Open-Research-Technologies-Hub/FARESHARE/hardware/3D print files/RFID Housing Left.STL

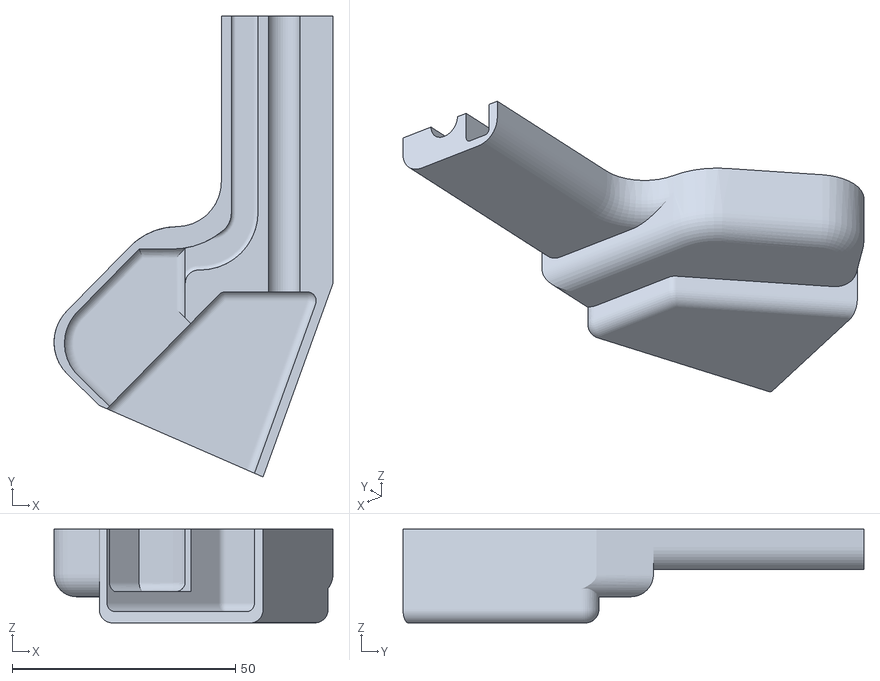
[picture p1: CAD file, 2024-04-05]
hardware/3D print files/RFID Housing Left.STL
62.4 x 103.2 x 21.0
