Open-Research-Technologies-Hub/FARESHARE/hardware/3D print files/Box.STL

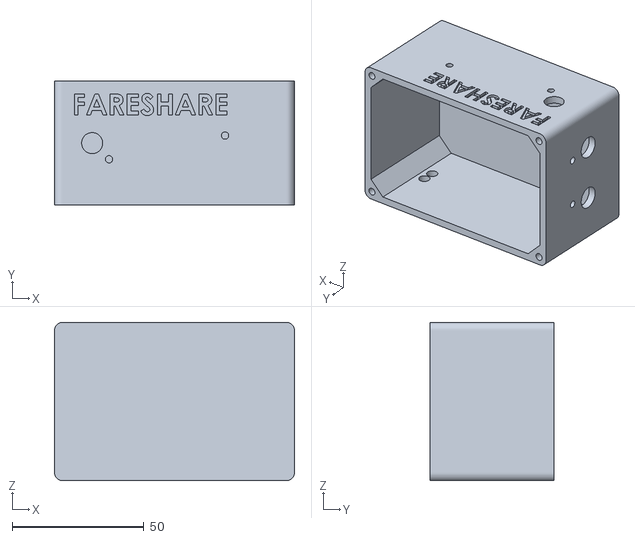
[picture p2: CAD file, 2024-04-05]
hardware/3D print files/Box.STL
91.0 x 47.0 x 60.0
