Open-Research-Technologies-Hub/FARESHARE/hardware/3D print files/Pump Case.STL

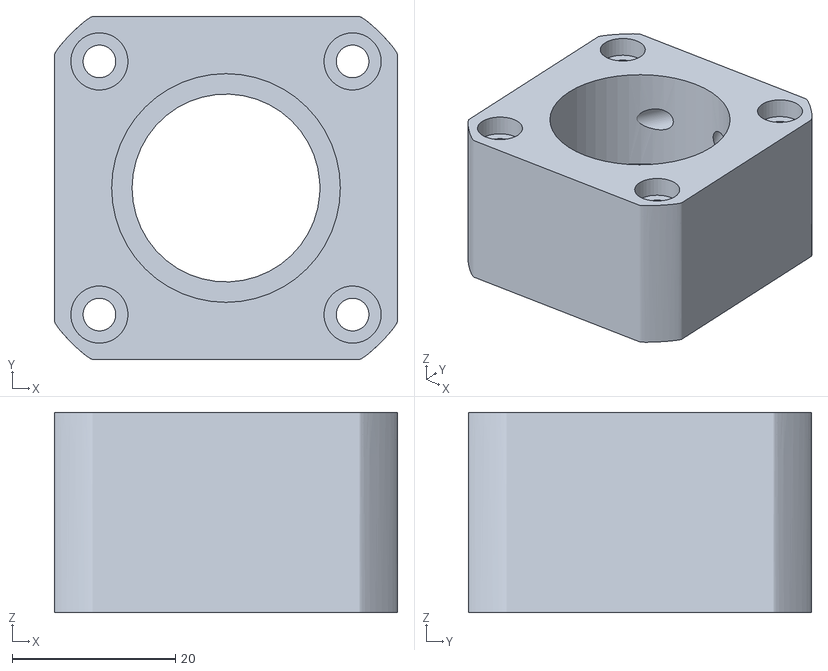
[picture p3: CAD file, 2024-04-05]
hardware/3D print files/Pump Case.STL
42.0 x 42.0 x 24.5
