Open-Research-Technologies-Hub/FARESHARE/hardware/3D print files/Box_lid.STL

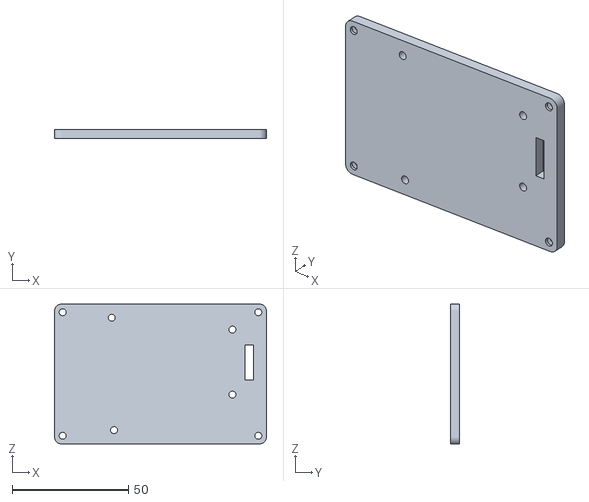
[picture p4: CAD file, 2024-04-05]
hardware/3D print files/Box_lid.STL
91.0 x 4.00 x 60.0
