Open-Research-Technologies-Hub/FARESHARE/hardware/3D print files/Rotor.STL

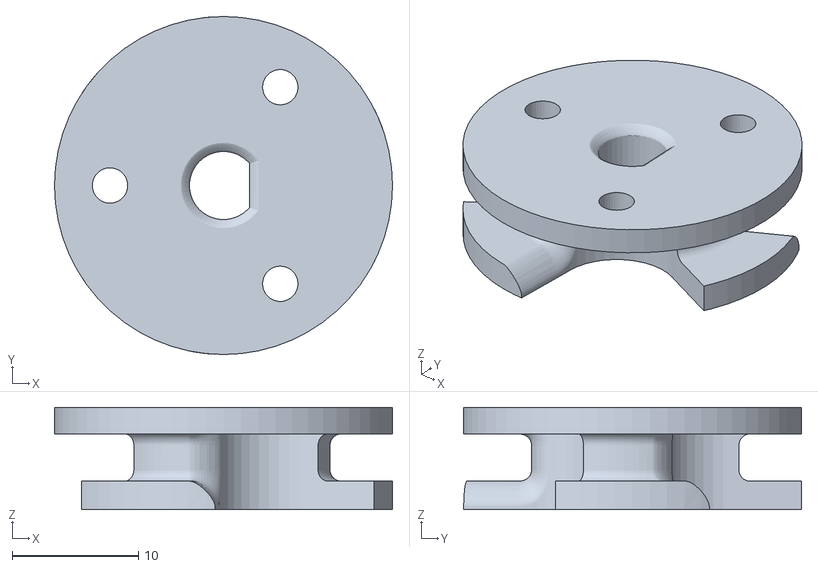
[picture p5: CAD file, 2024-04-05]
hardware/3D print files/Rotor.STL
26.8 x 26.8 x 8.10
