Open-Research-Technologies-Hub/FARESHARE/(list of files, cad)

Other CAD files:
hardware/3D print files/RFID Housing Right.STL
