Open-Research-Technologies-Hub/FARESHARE/(list of files, drawings)

Other design files:
FARESHARE PCB.fzz
