Open-Research-Technologies-Hub/FARESHARE/hardware/carvera_PCB/FARESHARE KICAD/FARESHARE KICAD.kicad_pcb

## KiCad design hardware/carvera_PCB/FARESHARE KICAD/FARESHARE KICAD.kicad_pcb (2024-05-10)

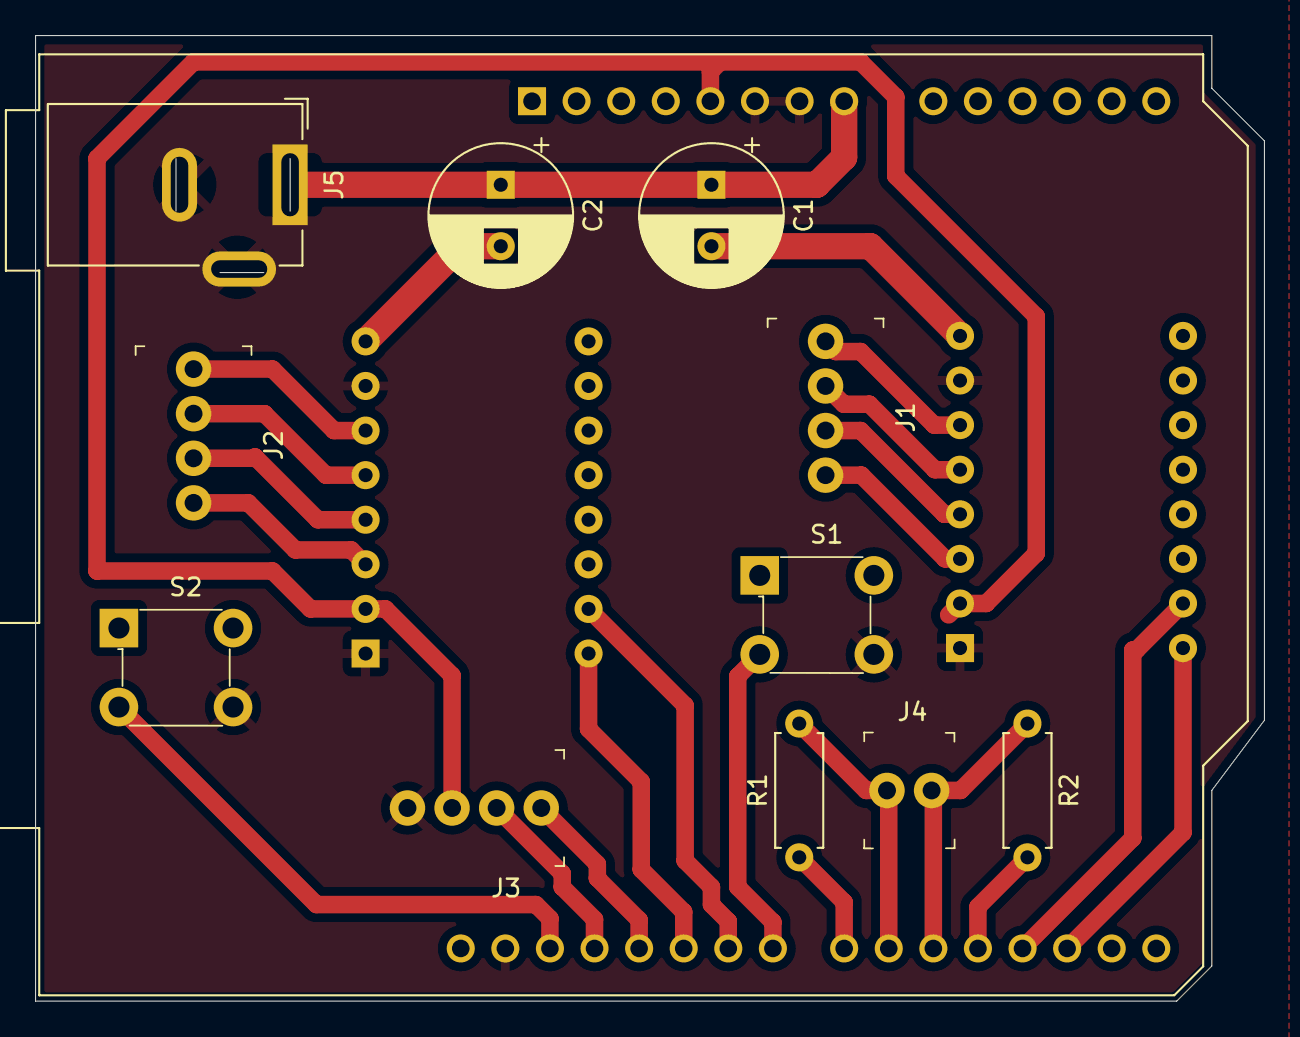
[picture p6: board FARESHARE KICAD.kicad_pcb from above]

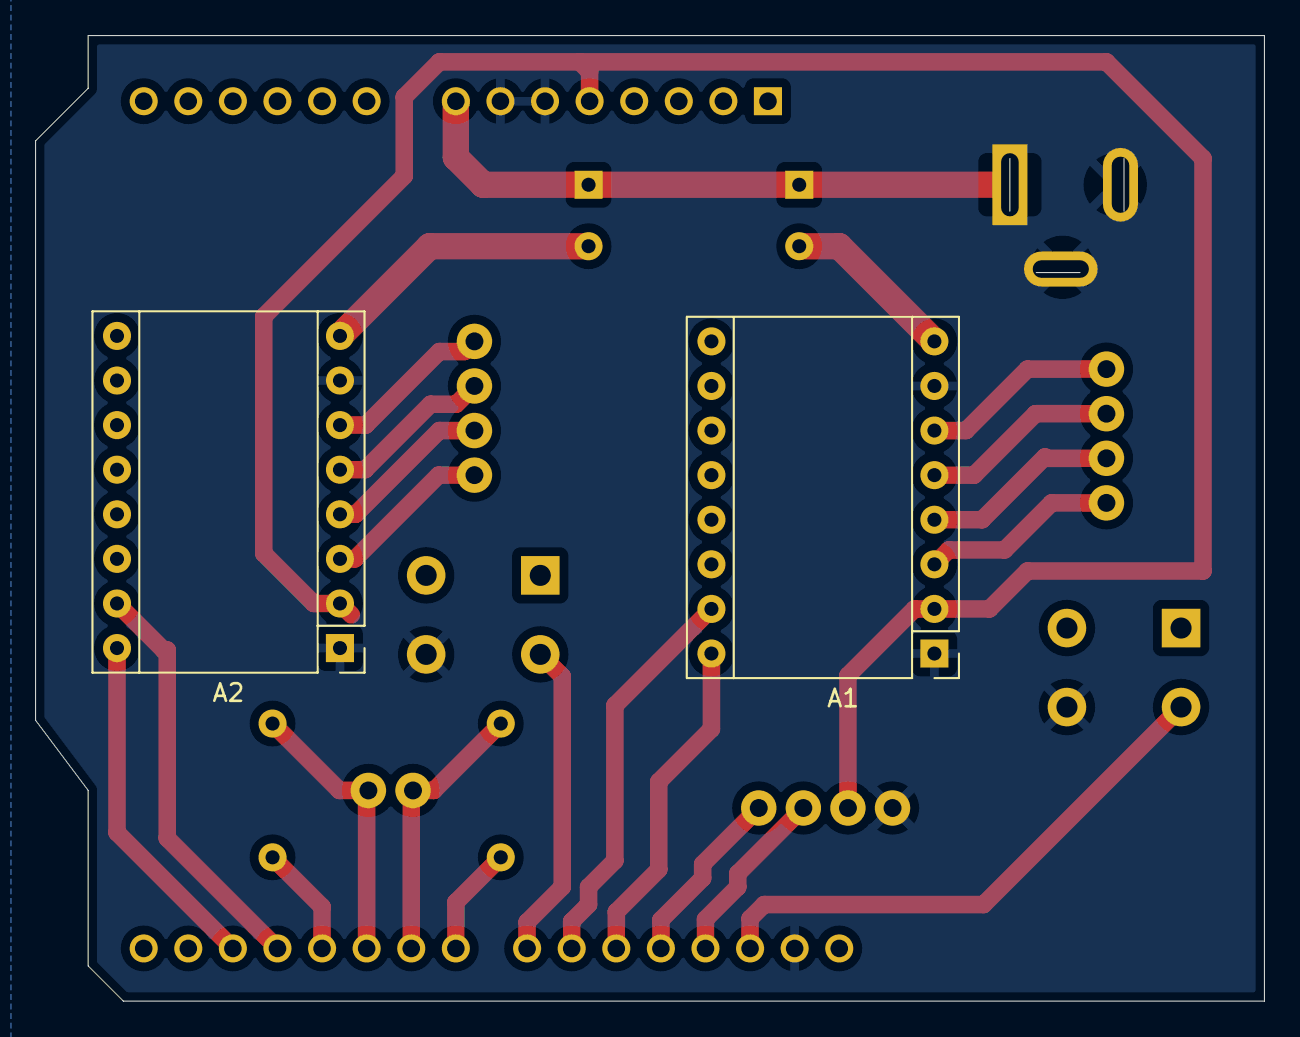
[picture p7: board FARESHARE KICAD.kicad_pcb from below]

Board: 2 copper layers, 70.0 x 55.0 mm, 14 parts (2 on the bottom side), 27 nets.

Parts:
A1, A2: Pololu_Breakout_A4988; Pololu_Breakout-16_15.2x20.3mm
A3: Arduino_UNO_R2
C1, C2: C_Polarized; CP_Radial_D8.0mm_P3.50mm
J1, J2, J3: 0022232041; PinHeader_1x4_P2.54mm_Drill1.02mm
J4: 22-23-2021; PinHeader_1x2_P2.54mm_Drill1.02mm
J5: Barrel_Jack_Switch_Pin3Ring; BarrelJack_GCT_DCJ200-10-A_Horizontal
R1, R2: R; R_Axial_DIN0207_L6.3mm_D2.5mm_P7.62mm_Horizontal
S1, S2: 1825910-6; Switch_Tactile_THT_6x6mm

Connections:
+5V: A1.2 (VDD), A2.2 (VDD), A3.5 (+5V), J3.3
+12V: A3.8 (VIN), C1.1, C2.1, J5.1
D2: A2.16 (DIR), A3.17 (D2)
D3: A2.15 (STEP), A3.18 (D3)
D4: A3.19 (D4), R2.2
D5: A3.20 (D5), J4.2, R2.1
D6: A3.21 (D6), J4.1, R1.2
D7: A3.22 (D7), R1.1
D8: A3.23 (D8), S1.3
D9: A1.15 (STEP), A3.24 (D9)
D10: A1.16 (DIR), A3.25 (D10)
D11: A3.26 (D11), J3.1
D12: A3.27 (D12), J3.2
D13: A3.28 (D13), S2.3
GND: A1.1 (GND), A1.7 (GND), A2.1 (GND), A2.7 (GND), A3.6 (GND), A3.7 (GND), A3.29 (GND), J3.4, J5.2, J5.3, S1.4, S2.4
unnamed: A1.4 (1A), J2.3
unnamed: A1.3 (1B), J2.4
unnamed: A1.5 (2A), J2.2
unnamed: A1.6 (2B), J2.1
unnamed: A1.8 (VMOT), C2.2
unnamed: A1.13 (~RESET), A1.14 (~SLEEP)
unnamed: A2.4 (1A), J1.3
unnamed: A2.3 (1B), J1.4
unnamed: A2.5 (2A), J1.2
unnamed: A2.6 (2B), J1.1
unnamed: A2.8 (VMOT), C1.2
unnamed: A2.13 (~RESET), A2.14 (~SLEEP)
