Open-Research-Technologies-Hub/FARESHARE/(commit log)

2024-04-05 move things around and create an editable BOM
    [Box.STL, Box_lid.STL, Pump Case.STL, RFID Housing Left.STL, RFID Housing Right.STL, Rotor.STL, fare_share_BOM.csv]
2024-04-19 move things around and create a board for carvera
    [FARESHARE PCB 2.0_contour.gm1, FARESHARE PCB 2.0_copperBottom.gbl, FARESHARE PCB 2.0_copperTop.gtl, FARESHARE PCB 2.0_maskBottom.gbs, FARESHARE PCB 2.0_maskTop.gts, FARESHARE PCB 2.0_silkBottom.gbo, FARESHARE PCB 2.0_silkTop.gto]
2024-05-05 added kicad pcb file
    [FARESHARE KICAD.kicad_pcb, FARESHARE KICAD.kicad_sch]
2024-05-06 circuit components added
2024-05-07 Kicad files updated
2024-05-07 PCb design and gerber files generated
    [FARESHARE KICAD-B_Cu.gbr, FARESHARE KICAD-B_Mask.gbr, FARESHARE KICAD-B_Paste.gbr, FARESHARE KICAD-B_Silkscreen.gbr, FARESHARE KICAD-Edge_Cuts.gbr, FARESHARE KICAD-F_Cu.gbr, FARESHARE KICAD-F_Mask.gbr, FARESHARE KICAD-F_Paste.gbr]
2024-05-07 Error corrected on Pcb and gerber file
2024-05-07 Pcb and gerber updated
    [FARESHARE KICAD-B_Cu.gbr, FARESHARE KICAD-B_Mask.gbr, FARESHARE KICAD-B_Paste.gbr, FARESHARE KICAD-B_Silkscreen.gbr, FARESHARE KICAD-Edge_Cuts.gbr, FARESHARE KICAD-F_Cu.gbr, FARESHARE KICAD-F_Mask.gbr, FARESHARE KICAD-F_Paste.gbr]
2024-05-08 added silk screen
    [FARESHARE KICAD.kicad_pcb, FARESHARE KICAD.kicad_sch]
2024-05-08 added the schematic file
    [FARESHARE KICAD.kicad_sch]
2024-05-08 gerbber files updated with a single sided pcb
    [FARESHARE KICAD-B_Cu.gbr, FARESHARE KICAD-B_Mask.gbr, FARESHARE KICAD-B_Paste.gbr, FARESHARE KICAD-B_Silkscreen.gbr, FARESHARE KICAD-Edge_Cuts.gbr, FARESHARE KICAD-F_Cu.gbr, FARESHARE KICAD-F_Mask.gbr, FARESHARE KICAD-F_Paste.gbr]
2024-05-08 updated pcb+ gerber
    [FARESHARE KICAD-B_Cu.gbr, FARESHARE KICAD-B_Mask.gbr, FARESHARE KICAD-B_Paste.gbr, FARESHARE KICAD-B_Silkscreen.gbr, FARESHARE KICAD-Edge_Cuts.gbr, FARESHARE KICAD-F_Cu.gbr, FARESHARE KICAD-F_Mask.gbr, FARESHARE KICAD-F_Paste.gbr]
2024-05-08 Cap size update
    [FARESHARE KICAD-B_Cu.gbr, FARESHARE KICAD-Edge_Cuts.gbr, FARESHARE KICAD-F_Cu.gbr, FARESHARE KICAD-F_Mask.gbr, FARESHARE KICAD-F_Paste.gbr, FARESHARE KICAD-NPTH.drl, FARESHARE KICAD-PTH.drl, FARESHARE KICAD-job.gbrjob]
2024-05-09 changed power footprint
    [FARESHARE KICAD-B_Cu.gbr, FARESHARE KICAD-Edge_Cuts.gbr, FARESHARE KICAD-F_Cu.gbr, FARESHARE KICAD-F_Mask.gbr, FARESHARE KICAD-F_Paste.gbr, FARESHARE KICAD-NPTH.drl, FARESHARE KICAD-PTH.drl, FARESHARE KICAD-job.gbrjob]
2024-05-10 changes on the barrel jack
    [FARESHARE KICAD-B_Cu.gbr, FARESHARE KICAD-Edge_Cuts.gbr, FARESHARE KICAD-F_Cu.gbr, FARESHARE KICAD-F_Mask.gbr, FARESHARE KICAD-F_Paste.gbr, FARESHARE KICAD-NPTH.drl, FARESHARE KICAD-PTH.drl, FARESHARE KICAD-job.gbrjob]
2024-05-10 barrel jack updated to a round one
    [FARESHARE KICAD-B_Cu.gbr, FARESHARE KICAD-Edge_Cuts.gbr, FARESHARE KICAD-F_Cu.gbr, FARESHARE KICAD-F_Mask.gbr, FARESHARE KICAD-F_Paste.gbr, FARESHARE KICAD-NPTH.drl, FARESHARE KICAD-PTH.drl, FARESHARE KICAD-job.gbrjob]
2024-05-10 Traces changed and other files updated accordingly
    [FARESHARE KICAD-B_Cu.gbr, FARESHARE KICAD-B_Mask.gbr, FARESHARE KICAD-B_Paste.gbr, FARESHARE KICAD-B_Silkscreen.gbr, FARESHARE KICAD-Edge_Cuts.gbr, FARESHARE KICAD-F_Cu.gbr, FARESHARE KICAD-F_Mask.gbr, FARESHARE KICAD-F_Paste.gbr]
2024-05-10 trying to use edge cut to cut slots
    [FARESHARE KICAD-B_Cu.gbr, FARESHARE KICAD-Edge_Cuts.gbr, FARESHARE KICAD-F_Cu.gbr, FARESHARE KICAD-F_Mask.gbr, FARESHARE KICAD-F_Paste.gbr, FARESHARE KICAD-NPTH.drl, FARESHARE KICAD-PTH.drl, FARESHARE KICAD-job.gbrjob]
2024-05-10 Will vias work?
    [FARESHARE KICAD-B_Cu.gbr, FARESHARE KICAD-Edge_Cuts.gbr, FARESHARE KICAD-F_Cu.gbr, FARESHARE KICAD-F_Mask.gbr, FARESHARE KICAD-F_Paste.gbr, FARESHARE KICAD-NPTH.drl, FARESHARE KICAD-PTH.drl, FARESHARE KICAD-job.gbrjob]
