Open-Research-Technologies-Hub/FARESHARE/(notices)

Notices in the files:
hardware/carvera_PCB/FARESHARE KICAD/FARESHARE KICAD.kicad_pcb:
creativecommons.org/licenses/by/4.0
License: CC BY 4.0
